AleDedor/STM32Nucleo-Codec-Shield/project_slides.pdf

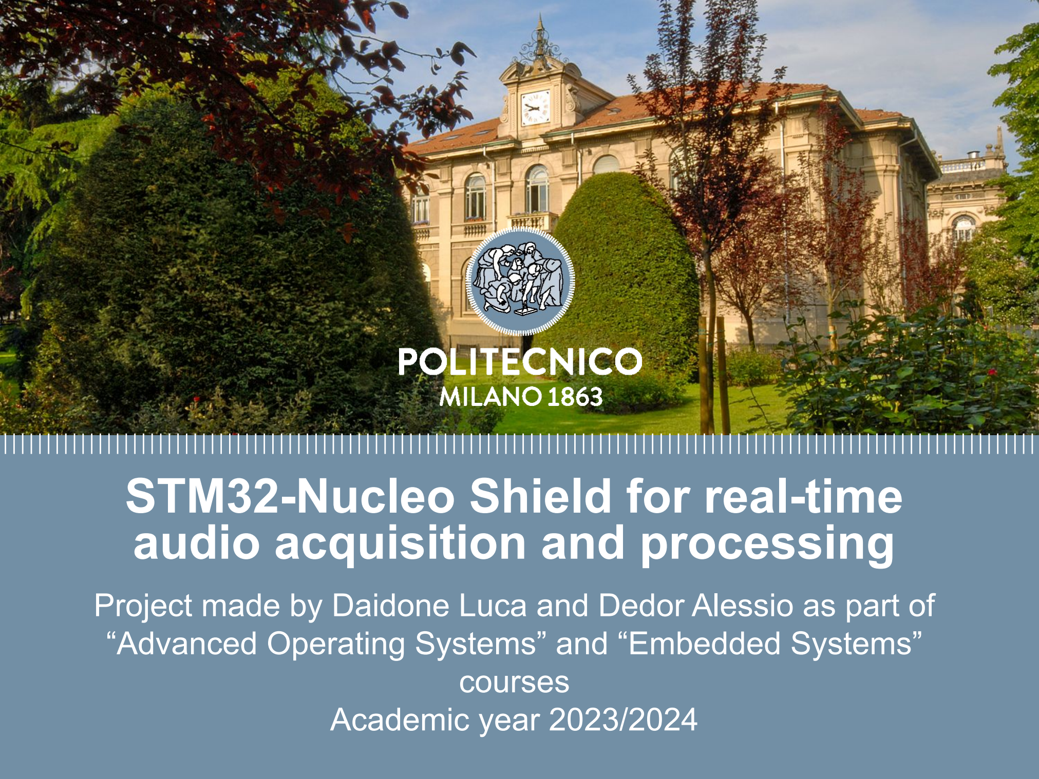
[picture p9: page 1]

### Titolo presentazione sottotitolo

Milano, XX mese 20XX

## STM32-Nucleo Shield for real-time audio acquisition and processing

Project made by Daidone Luca and Dedor Alessio as part of “Advanced Operating Systems” and “Embedded Systems” courses
Academic year 2023/2024

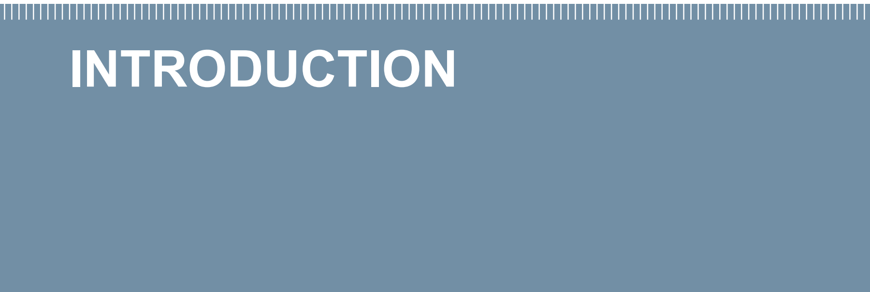
[picture p10: figure]
Firma convenzione; del Duomo di Milano; Aula Magna – Rettorato Mercoledì 27 maggio 2015; INTRODUCTION

### Politecnico di Milano e Veneranda Fabbrica

STM32 Nucleo Audio Shield project

## Project goals

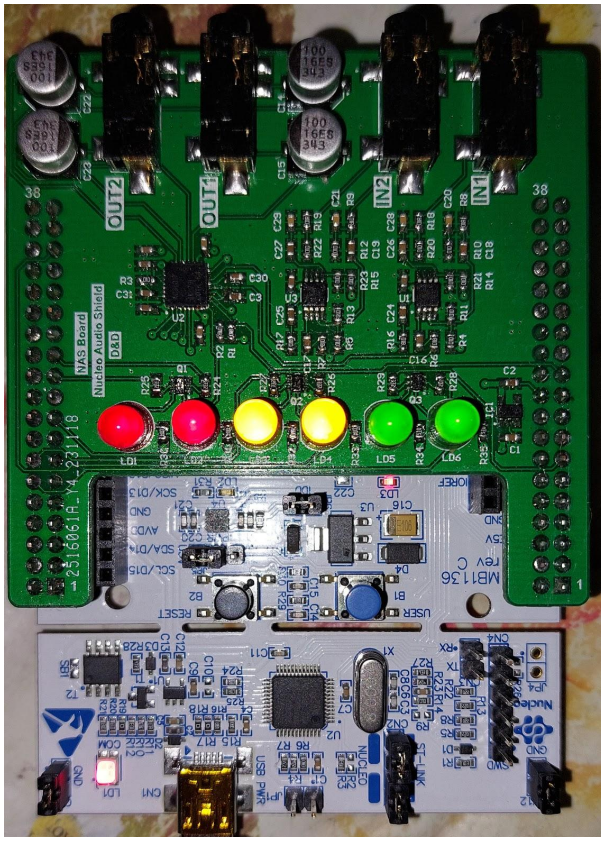
[picture p11: figure]

Design of a | TLV320AIC3101 Codec | based
shield targeting | STM32F401RE Nucleo
boards | and | development | of | a
multi-threaded | program | for | real-time
audio data processing.

Aim of the project is to:
1. Design and realize a custom “shield” to add audio processing capabilities to the STM32 Nucleo boards
2. Use the embedded RTOS “Miosix” to implement an I2S Driver and exploit
the | advantages | of | multi-threaded
programming

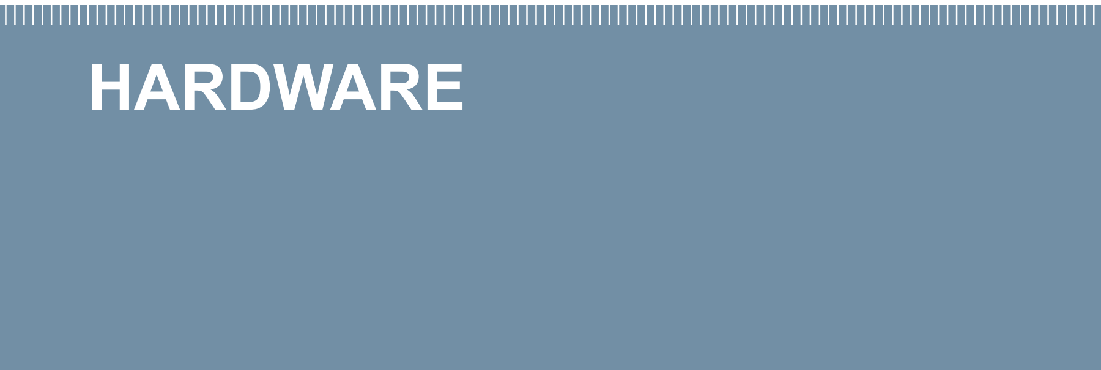
[picture p12: figure]
Firma convenzione; del Duomo di Milano; Aula Magna – Rettorato Mercoledì 27 maggio 2015; HARDWARE

### Politecnico di Milano e Veneranda Fabbrica

Starting from the schematic..

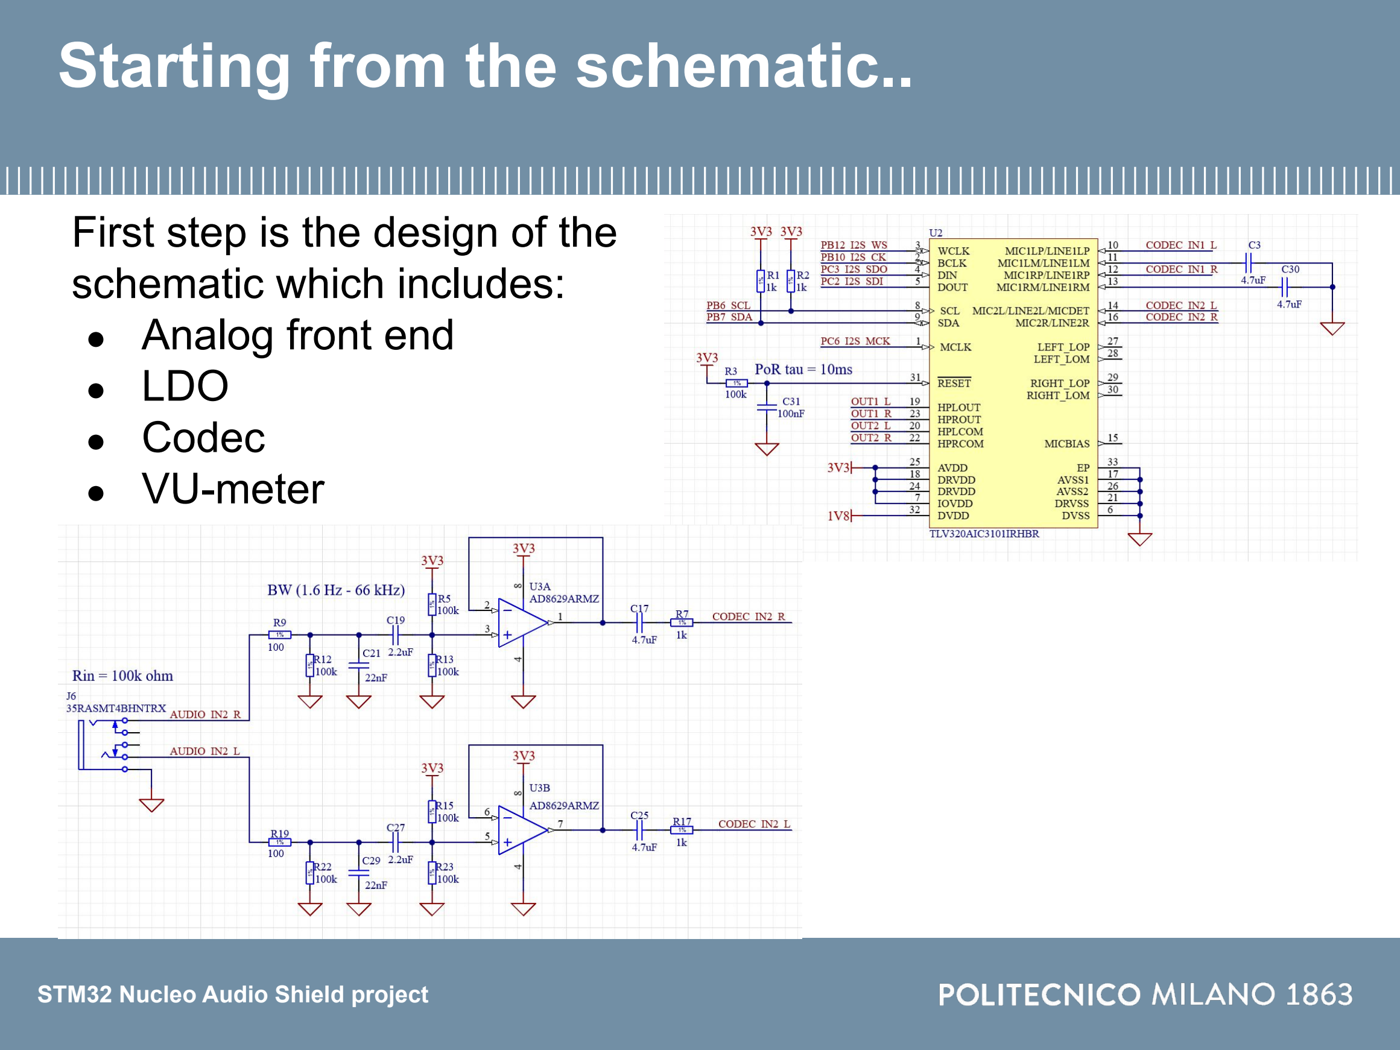
[picture p13: page 5]

First step is the design of the schematic which includes:
- Analog front end
- LDO
- Codec
- VU-meter

## Full schematic

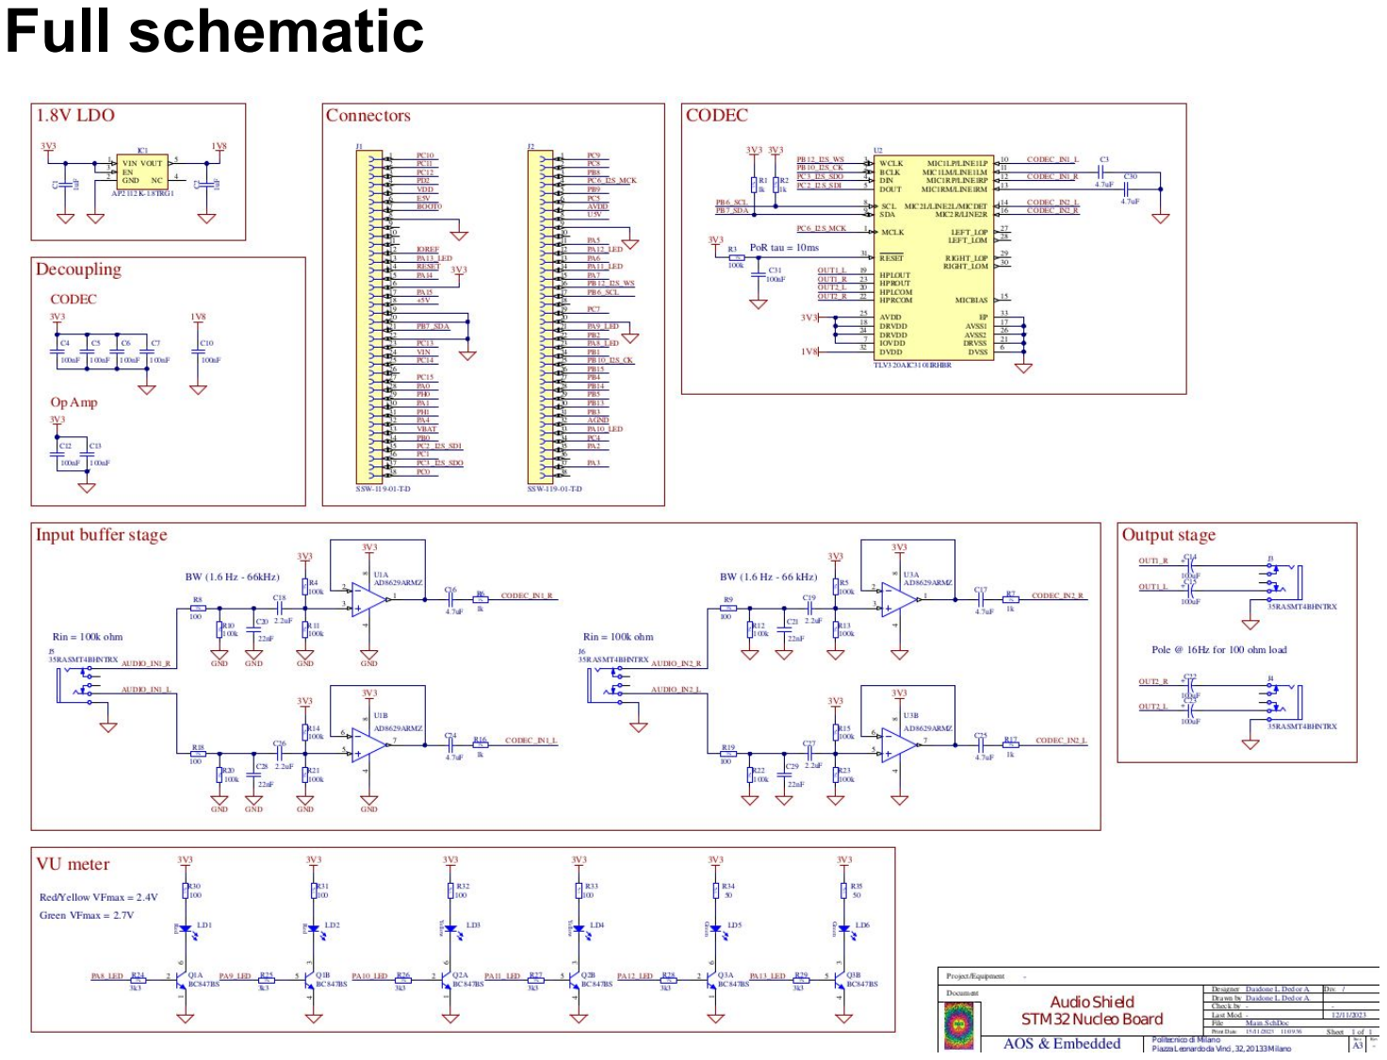
[picture p14: page 6]

# Full Schematic

## ..continuing to the Layout

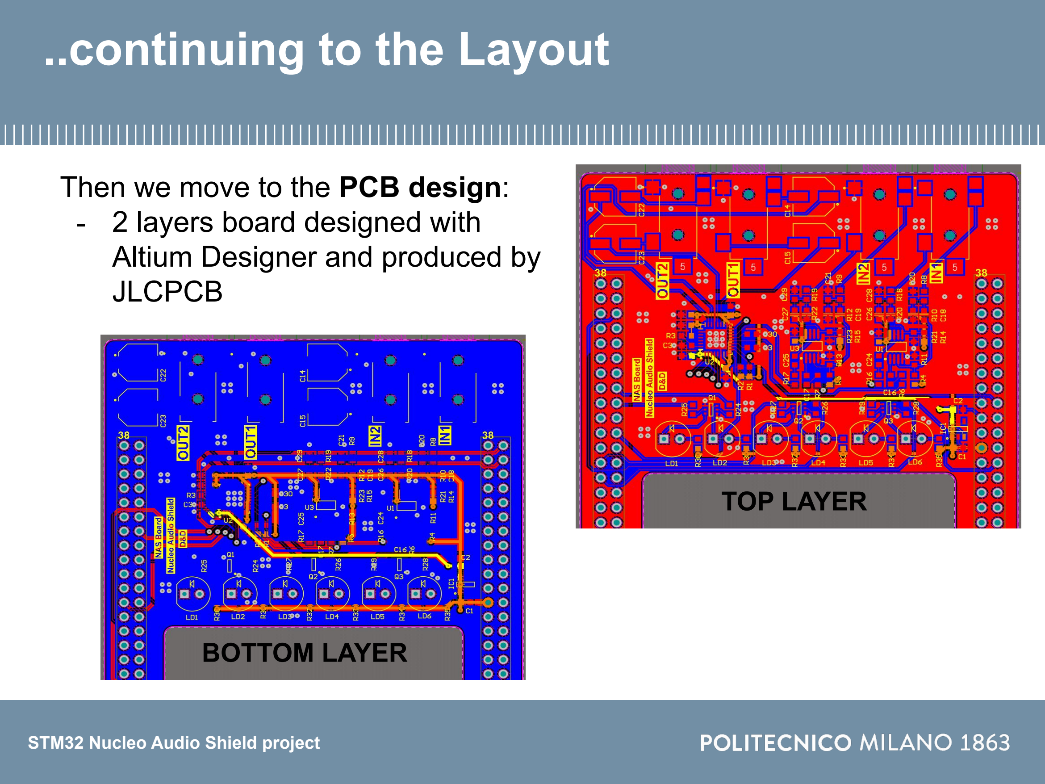
[picture p15: page 7]

Then we move to the PCB design:
- 2 layers board designed with Altium Designer and produced by JLCPCB

BOTTOM LAYER

TOP LAYER

## ..and finishing with soldering + testing

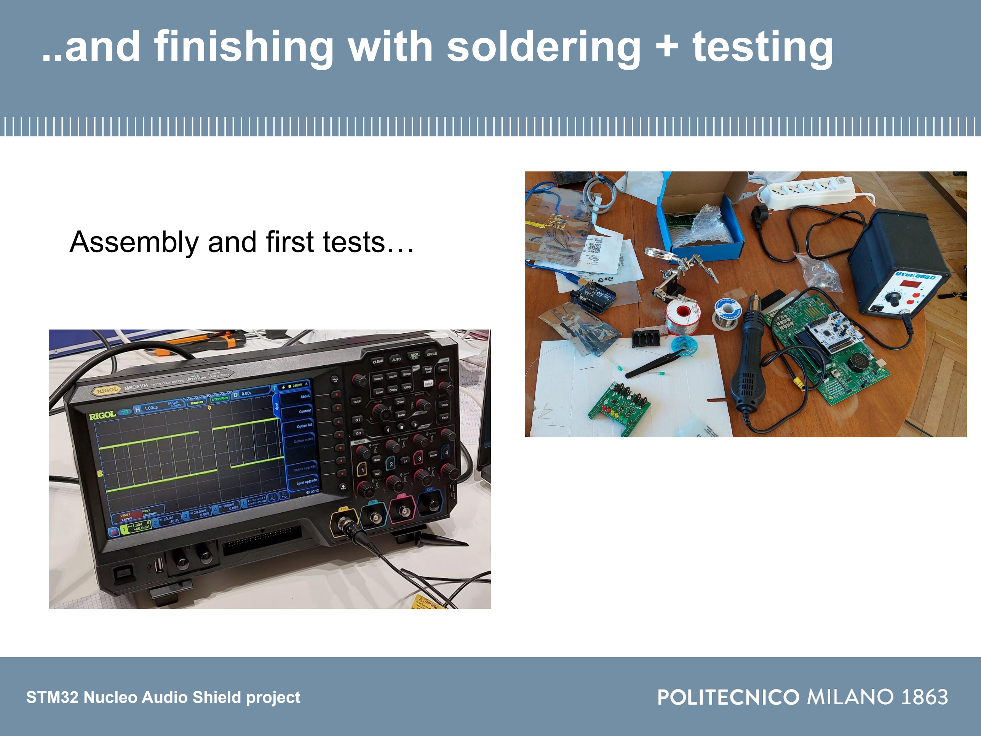
[picture p16: page 8]

Assembly and first tests…

## Final considerations (HW)

Problems encountered:

1. VU-meter was meant to have 6 fully working LEDs but only 5 of them can be currently used. One is directly connected to the SWD port and setting it as an output would not allow us to successfully “flash” the MCU using the “st-flash” tool. This can probably be easily fixed but was not investigated yet
2. Signal Integrity: due to initial misunderstanding about the I2S protocol, a trace carrying audio signals was routed close to traces carrying high frequency digital signals causing some audible distortion under certain conditions
3. The selected Codec comes in a package which is not easy to solder. A too long heat exposition damaged the output audio stage

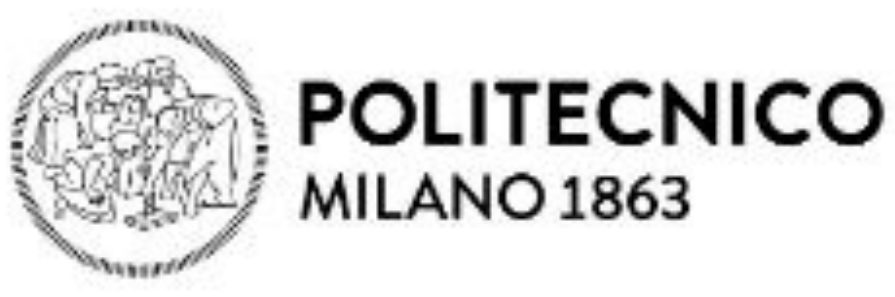
[picture p17: figure]
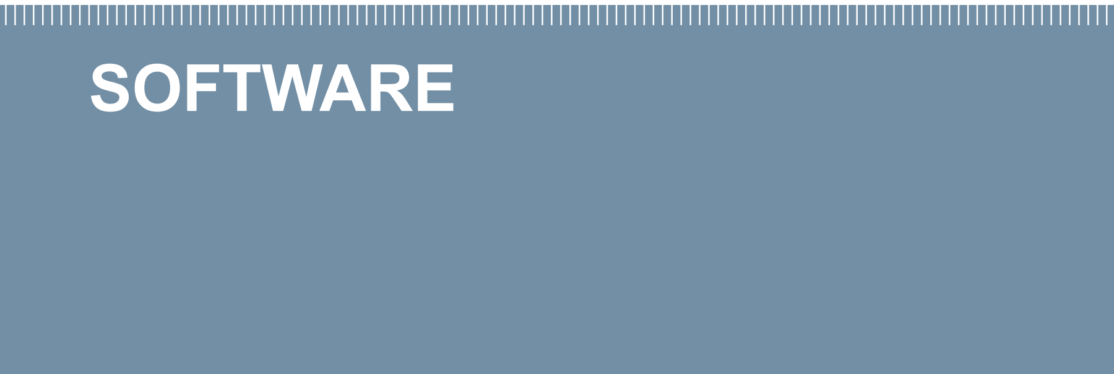
[picture p18: figure]
Firma convenzione; del Duomo di Milano; Aula Magna – Rettorato Mercoledì 27 maggio 2015; SOFTWARE

### Politecnico di Milano e Veneranda Fabbrica

## Goals

Software must provide libraries/functions to easily manage all the HW present on the board, which are:
- Codec
- VU-meter
- I2S peripherals on codec and STM32

Finally, a simple loopback and a VU-meter showcase should be realized.

## VU-Meter

The class “Vumeter” takes the specified GpioPin (5 pins) and provides some basic methods.

- The constructor set the specified pins, passed as parameters, as “outputs”.
- setHigh() and clear() allow to turn on/off all the leds of the VU-meter.
- showVal(uint), finally takes the sound value, converts it in a log scale and turns on the corresponding number of leds.

The class is defined inside the vumeter.h header file.

## VU-Meter

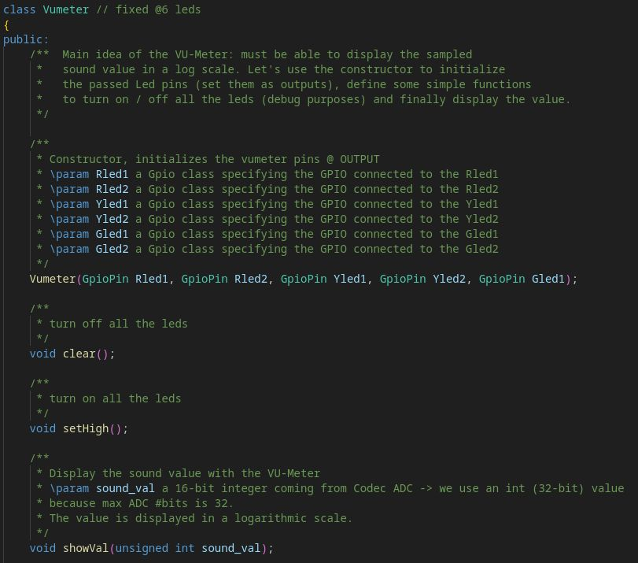
[picture p19: figure]

## Codec driver: TLV320AIC3101 class

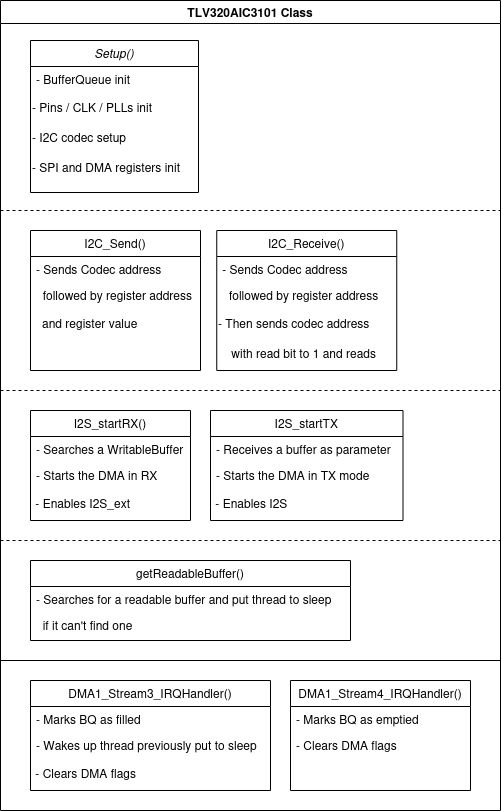
[picture p20: figure]

## Codec

The class “TLV3203101AIC” instantiate the codec object in a Singleton manner such as only one instance can exist.

The codec uses two different communication protocols:
- I2C, it is needed to change the codec settings/functionalities and directly R/W its registers
- I2S, used to receive/transfer audio data

The class is defined inside the TLV3203101AIC.h header file, while all the implementations are moved inside the TLV3203101AIC.cpp file.

## Codec

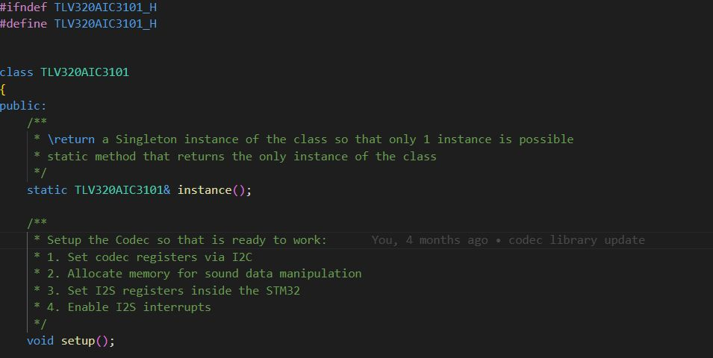
[picture p21: figure]

## Codec - I2C

In order to easily communicate through I2C protocol:
1. We used the “SoftwareI2C” class of Miosix to implement two
methods, “I2C_Send(unsigned | char | regAddress, | char | data)“ and
“
I2C_Receive(unsigned | char | regAddress)

“

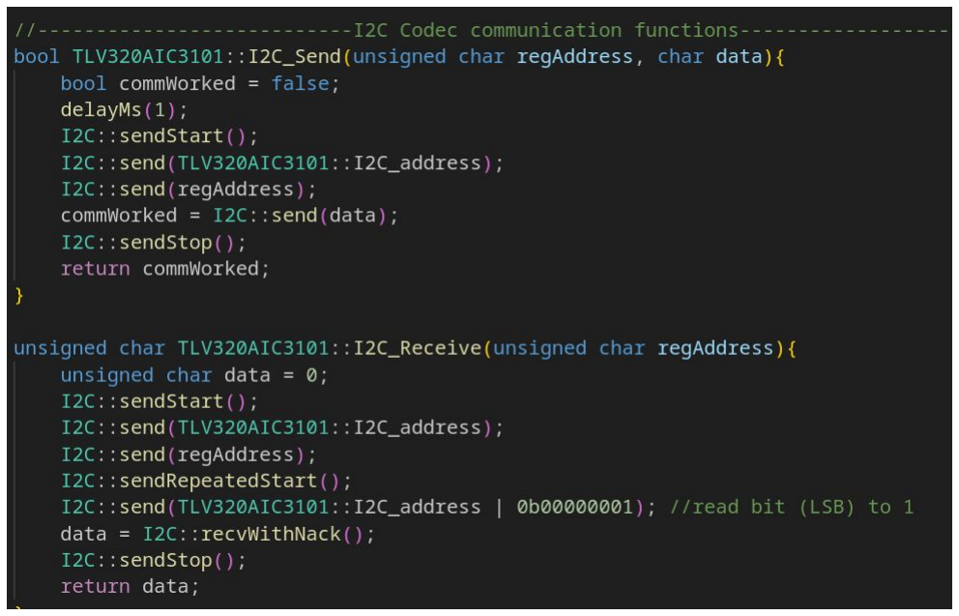
[picture p22: figure]

## Codec - I2C

2. Then we implemented a “setup()” method where the “I2C_Send()” function is used to setup the I2C peripheral and initialize all the needed codec registers.

And so on…

## Codec - I2S

Audio data is sampled by the codec and then transferred to the MCU through I2S protocol. Since our goal is to receive and then send back the manipulated audio data, we need to exploit the I2S in full-duplex mode. Also, in order to avoid keeping the CPU busy, we use the DMA and its interrupt routines.

Therefore an “I2S driver” is needed. For this purpose, the TLV320AIC3101 class has the following methods:

- | void | setup();
- | static | bool | I2S_startRx();
- | static | void | I2S_startTx(const | unsigned | short | *buffer_tx);

## Codec - I2S - setup()

In the “setup()” function the following steps are performed:
- enable peripherals clock (DMA1/SPI2)
- setup I2S pins (with correct AF number)
- configure I2S PLL
- configure I2S2/I2S2_ext working mode (Master/Slave)
- setup relative DMAx streams
- enable interrupts

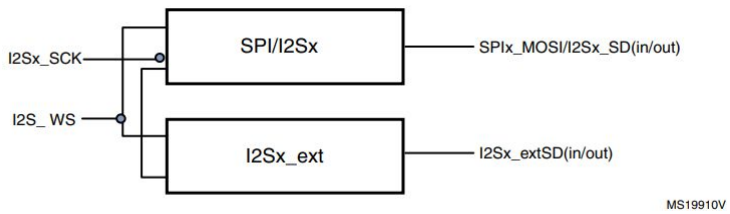
[picture p23: figure]

## Codec - I2S - I2S_startRx()/I2S_startTx()

The role of the “I2S_startRx()” function is to:
- find a writable buffer among the ones of the BufferQueue
- Set DMA1 (Stream 3) to transfer from peripheral (I2S) to memory, then start it
- enable I2S2_ext peripheral

Similarly the role of the “I2S_startTx()” function is to:
- take the buffer filled with audio data as a parameter
- Set DMA1 (Stream 4) to transfer from memory to peripheral, then start it
- enable SPI2 (I2S2) peripheral

Note that both these methods use a “FastInterruptDisableLock dLock;” before setting everything up.

## DMA1 ISR

Since both DMA1 Stream3/Stream4 interrupts have been enabled, we need to manage the relative Interrupt Service Routines. Apart from clearing all the interrupts flags we basically just mark the buffer which was just transmitted as “empty” and the one that was received as “filled”.

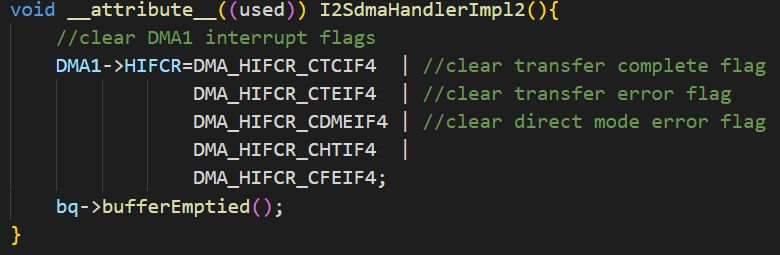
[picture p24: figure]

## DEMO

Finally inside the “main.cpp” file we implemented a simple showcase of the project. The main idea here is:

- to create a thread that manages the VU-meter displaying the audio values when a buffer is readable
- create another thread that uses the methods described before to start I2S in RX mode and TX mode in order to implement a simple loopback - audio is immediately sent back as soon as it is received

In order to avoid that the data buffer is modified while it is being read by the VU-meter thread, a “Lock<Mutex> lock(mutex);” is employed

## Demo flow chart

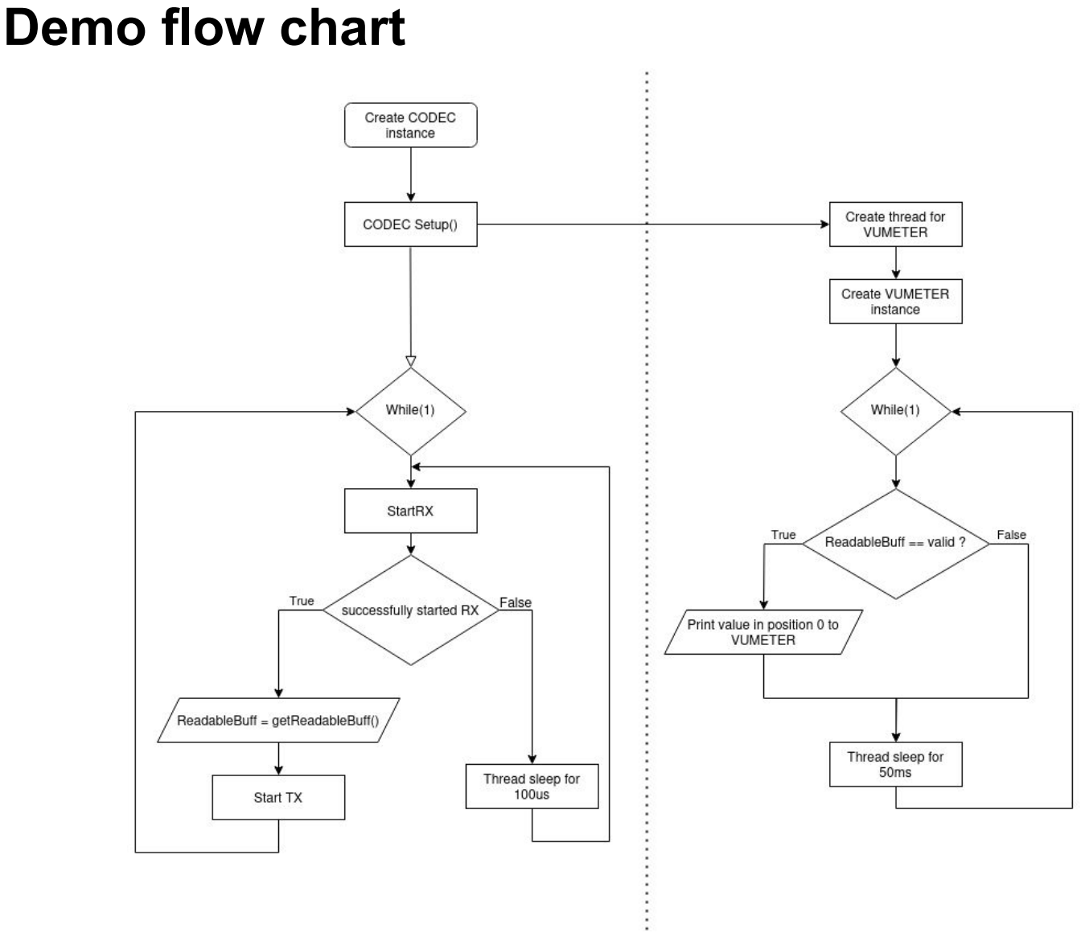
[picture p25: page 24]

## Flowchart
