AleDedor/STM32Nucleo-Codec-Shield/Schematic/Nucleo_Codec_Shield.pdf

3V3 | 1V8

3V3

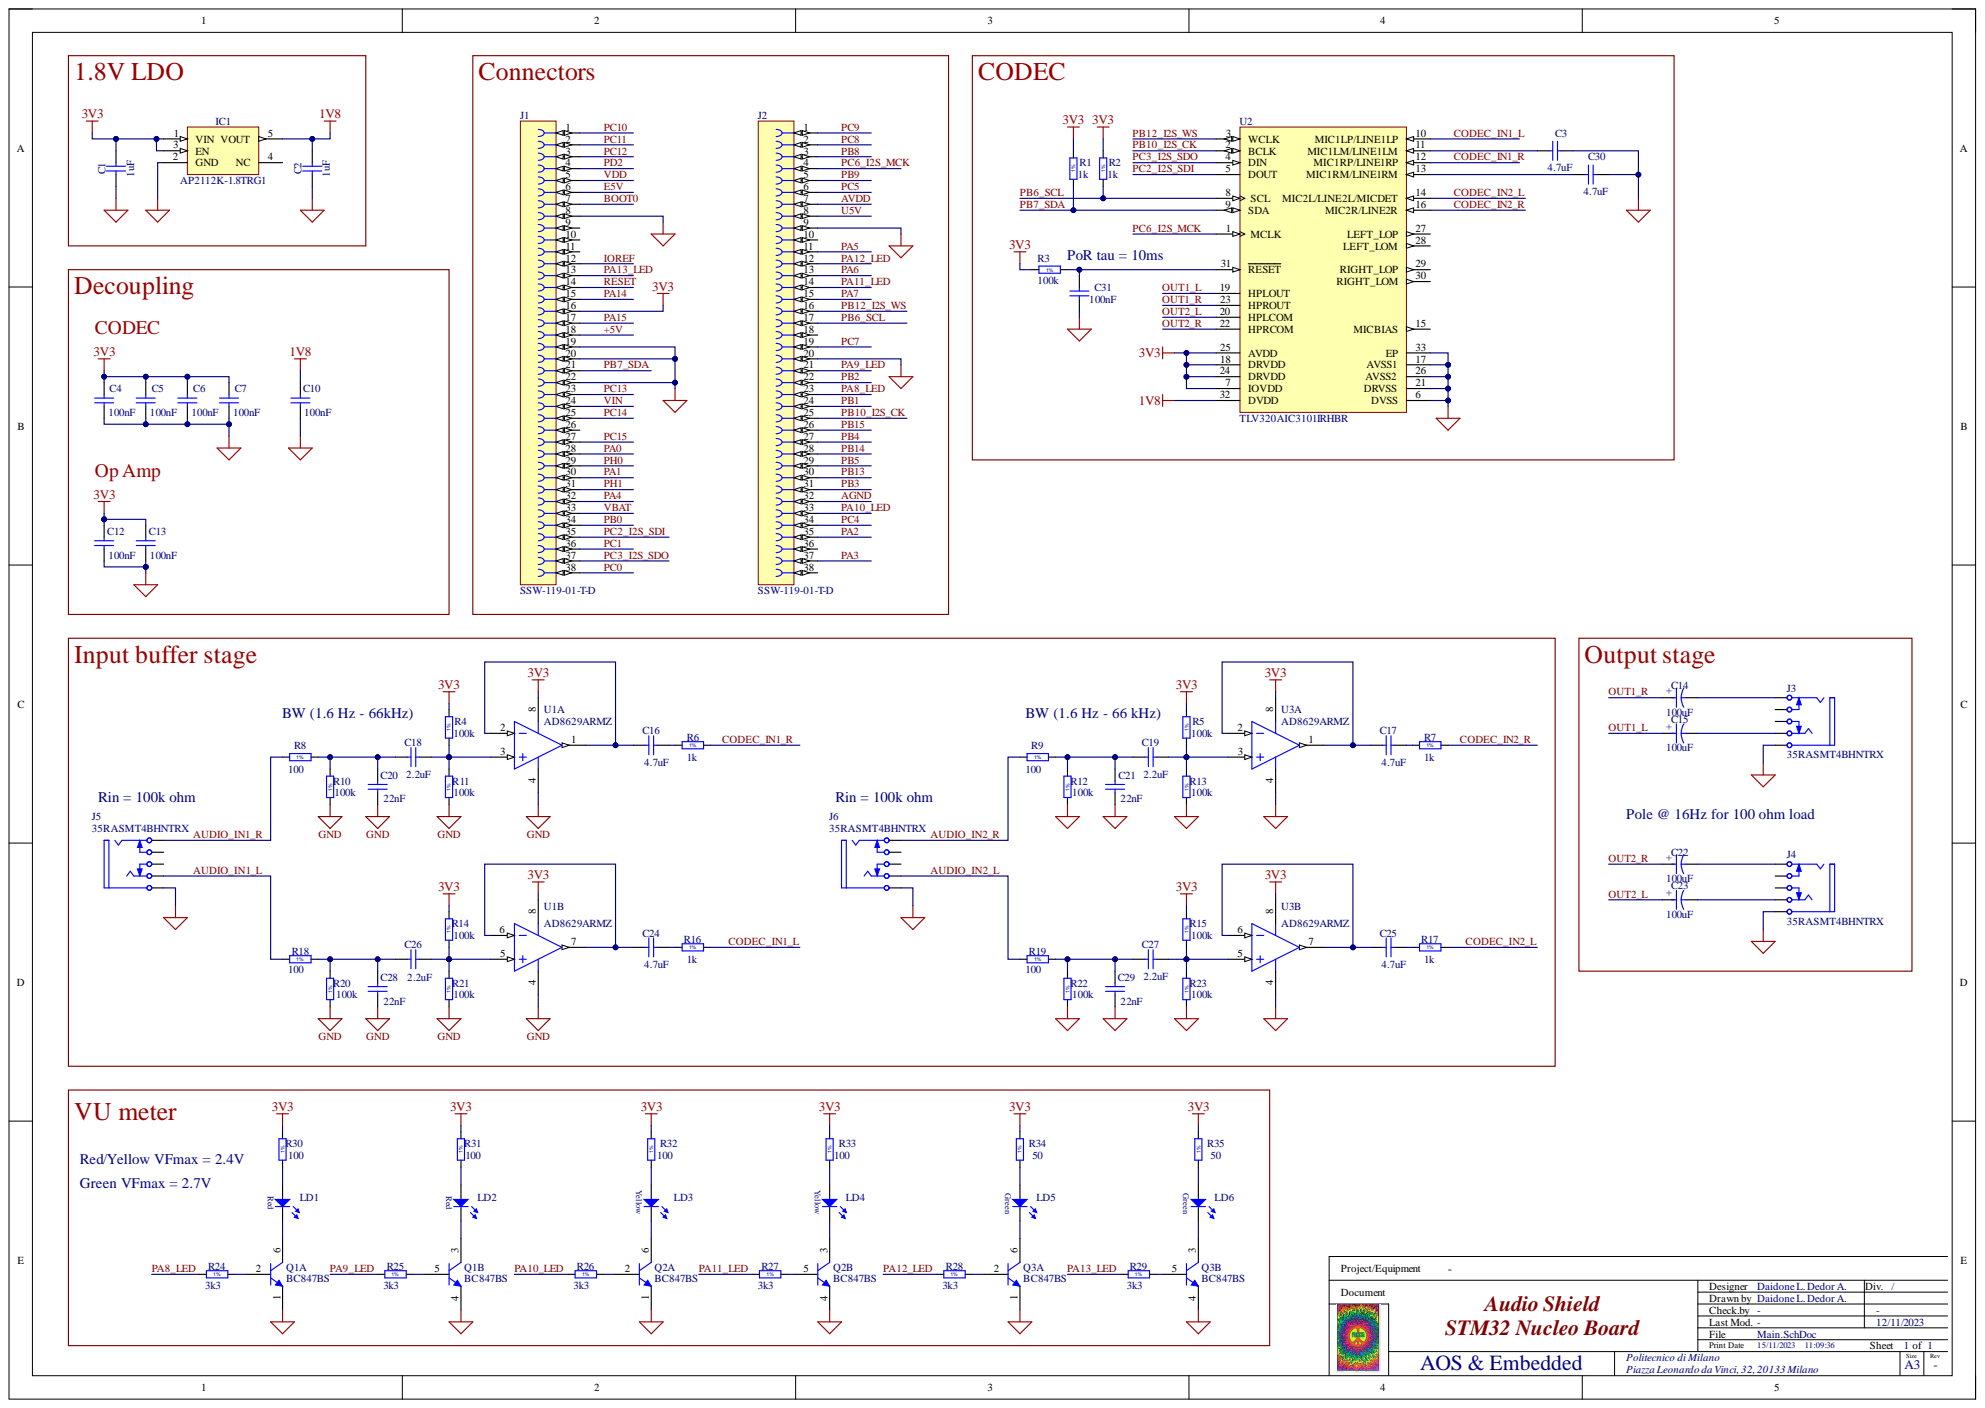
[picture p26: page 1]

Pole @ 16Hz for 100 ohm load

Designer DaidoneL. Dedor A.
Drawn by DaidoneL. Dedor A.

Politecnico di Milano
Piazza Leonardo da Vinci, 32, 20133 Milano

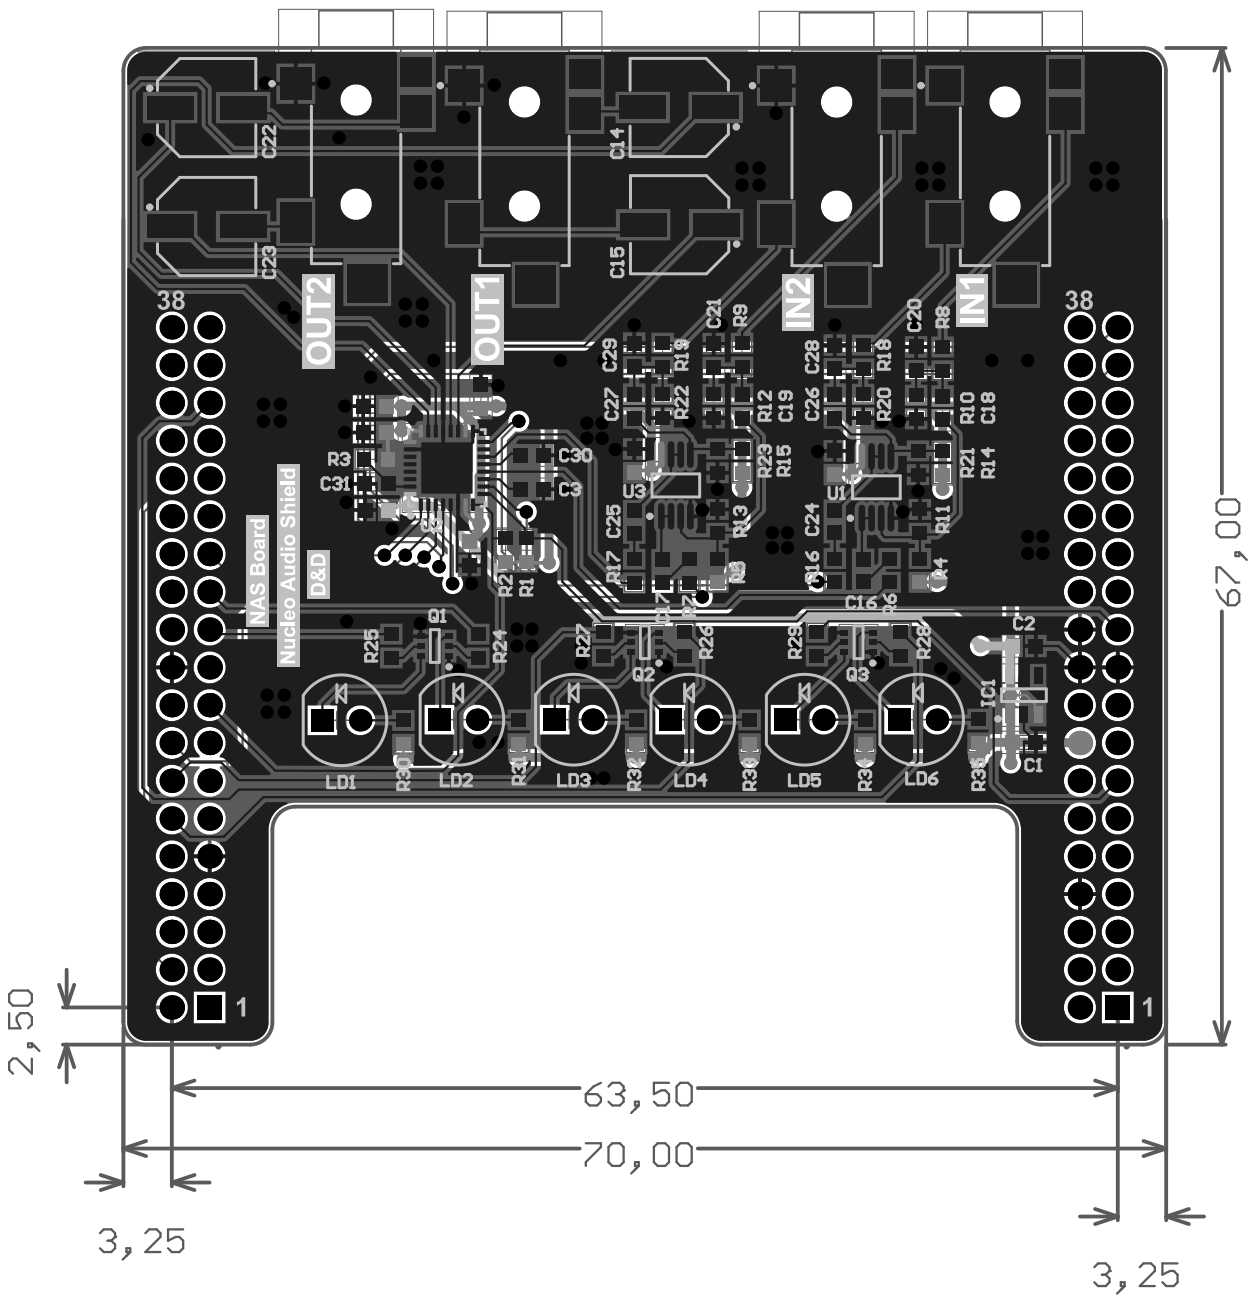
[picture p27: page 2]
