AleDedor/STM32Nucleo-Codec-Shield/Simulation/Analogue_IN.asc

C1: cap; 2µ
C3: cap; 470p
C4: cap; 1µ
C5: cap; 22n
R1: res; 100k
R2: res; 100k
R3: res; 100
R4: res; 100k
R5: res; 100k
R6: res; 100
R7: res; 100k
U1: AD8629
V1: voltage; 3.3
V2: voltage; SINE(0 10m 20k); AC 10m
V3: voltage; 1.65
Named nets: 0, 3V3, 1V65, audio
.ac dec 100 0.1m 10Meg
2 CONDENSATORI = LIMITARE BANDA (HP + LP)
SOLUZIONE DI PHIL'S = RICHIEDE OPAMP PER IL BIAS :(
SOLUZIONE MIA = NO OPA PER BIAS, POLO HF CON LEGGERE Q FACTOR ELEVATO
.tran 0.2m
Q-FACTOR ABBASSATO PONENDO PRIMA IL CONDENSATORE, 100k INPUT PER EVITARE FLOATING
