AleDedor/STM32Nucleo-Codec-Shield/NAS_Loopback_2/Core/Src/main.c

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
/* Includes ------------------------------------------------------------------*/
#include "main.h"

/* USER CODE BEGIN Includes */
#include "stdio.h"
#include "TLV320AIC3101_Codec.h"
/* USER CODE END Includes */

/* USER CODE BEGIN PD */
#define HIGH 1
#define LOW 0
#define NUM_LEDS 5
#define TIMEOUT 500
#define BUFF_SIZE 50
#define RESET_TIME 50 
/* USER CODE END PD */

I2C_HandleTypeDef hi2c1;

I2S_HandleTypeDef hi2s2;
DMA_HandleTypeDef hdma_spi2_tx;
DMA_HandleTypeDef hdma_i2s2_ext_rx;

TIM_HandleTypeDef htim3;

UART_HandleTypeDef huart2;

/* USER CODE BEGIN PV */
uint8_t TIM3_ISR_FLAG = 0;
uint16_t LED_PIN[NUM_LEDS]={RLED1_Pin, RLED2_Pin, YLED1_Pin, YLED2_Pin, GLED1_Pin};
Codec codec;
// buffer of sound data where odd indexes are left channel, even are right one
uint16_t rx_data[BUFF_SIZE];
uint16_t tx_data[BUFF_SIZE];
static volatile uint16_t* inBufPtr;
static volatile uint16_t* outBufPtr = &tx_data[0];
char buff[100];
/* USER CODE END PV */

void SystemClock_Config(void);
static void MX_GPIO_Init(void);
static void MX_DMA_Init(void);
static void MX_USART2_UART_Init(void);
static void MX_I2C1_Init(void);
static void MX_TIM3_Init(void);
static void MX_I2S2_Init(void);
/* USER CODE BEGIN PFP */
static void Led_Clear();
//static void Codec_Setup();
/* USER CODE END PFP */

/* USER CODE BEGIN 0 */
static void Led_Clear(){
	HAL_GPIO_WritePin(GPIOA, RLED1_Pin|RLED2_Pin|YLED1_Pin|YLED2_Pin|GLED1_Pin, GPIO_PIN_RESET);
}

/* 2 DMA streams are used, 1 RX ,1 TX */
/* move half of the receiving DMA into the half of the transmitting DMA */
void process_half(){

	uint16_t volume = 0;

	for(uint8_t n=0 ; n < (BUFF_SIZE/2) - 1; n++){
		//LEFT
		*(outBufPtr+n)=*(inBufPtr+n); //tx_data --> rx_data
		//RIGHT
		//outBufPtr[n+1]=inBufPtr[n+1];

		//VU METER FATTO MALE SOLO PER PROVARE
		volume = (*(inBufPtr+n));
		Led_Clear();
		if(volume>55296){
			HAL_GPIO_WritePin(GPIOA, LED_PIN[0], HIGH);
			HAL_GPIO_WritePin(GPIOA, LED_PIN[1], HIGH);
			HAL_GPIO_WritePin(GPIOA, LED_PIN[2], HIGH);
			HAL_GPIO_WritePin(GPIOA, LED_PIN[3], HIGH);
			HAL_GPIO_WritePin(GPIOA, LED_PIN[4], HIGH);
			//HAL_GPIO_WritePin(GPIOA, LED_PIN[5], HIGH);
		}else if(volume<55296 && volume>13824){
			HAL_GPIO_WritePin(GPIOA, LED_PIN[1], HIGH);
			HAL_GPIO_WritePin(GPIOA, LED_PIN[2], HIGH);
			HAL_GPIO_WritePin(GPIOA, LED_PIN[3], HIGH);
			HAL_GPIO_WritePin(GPIOA, LED_PIN[4], HIGH);
			//HAL_GPIO_WritePin(GPIOA, LED_PIN[5], HIGH);
		}else if(volume<13824 && volume>4608){
			HAL_GPIO_WritePin(GPIOA, LED_PIN[2], HIGH);
			HAL_GPIO_WritePin(GPIOA, LED_PIN[3], HIGH);
			HAL_GPIO_WritePin(GPIOA, LED_PIN[4], HIGH);
			//HAL_GPIO_WritePin(GPIOA, LED_PIN[5], HIGH);
		}else if(volume<4608 && volume>1536){
			HAL_GPIO_WritePin(GPIOA, LED_PIN[3], HIGH);
			HAL_GPIO_WritePin(GPIOA, LED_PIN[4], HIGH);
			//HAL_GPIO_WritePin(GPIOA, LED_PIN[5], HIGH);
		}else if(volume<1536 && volume>512){
			HAL_GPIO_WritePin(GPIOA, LED_PIN[4], HIGH);
			//HAL_GPIO_WritePin(GPIOA, LED_PIN[5], HIGH);
		}else if(volume<512 && volume>0){
			//HAL_GPIO_WritePin(GPIOA, LED_PIN[5], HIGH);
		}
	}
}

/* first half ready DMA callback*/
void HAL_I2SEx_TxRxHalfCpltCallback(I2S_HandleTypeDef *hi2s){
	inBufPtr = rx_data; // pointing to rx_data of DMA
	outBufPtr = tx_data; // pointing to tx_data of DMA
	process_half(); // move data from RX to TX DMA

}
/* second half ready DMA callback*/
void HAL_I2SEx_TxRxCpltCallback(I2S_HandleTypeDef *hi2s){
	inBufPtr = (rx_data + BUFF_SIZE/2);
	outBufPtr = (tx_data + BUFF_SIZE/2);
	process_half(); // move data from RX to TX DMA
}
/*
void HAL_I2S_RxHalfCpltCallback(I2S_HandleTypeDef *hi2s){
	//HAL_I2S_Transmit_(hi2s, rx_data, BUFF_SIZE/2, 10);
	HAL_I2S_Transmit_DMA(&hi2s2, rx_data, BUFF_SIZE/2);
}
void HAL_I2S_RxCpltCallback(I2S_HandleTypeDef *hi2s){
	//HAL_I2S_Transmit(hi2s, (rx_data + BUFF_SIZE/2), BUFF_SIZE/2, 10);
	HAL_I2S_Transmit_DMA(&hi2s2, (rx_data + BUFF_SIZE/2), BUFF_SIZE/2);
}
*/
/*TIMER 3 used to turn on LED every second*/
void HAL_TIM_PeriodElapsedCallback(TIM_HandleTypeDef *htim){
	if(htim == &htim3)
		TIM3_ISR_FLAG = 1;
}


/* USER CODE END 0 */

/**
  * @brief  The application entry point.
  * @retval int
  */
int main(void)
{
  /* USER CODE BEGIN 1 */
  uint8_t led_index = 0, len = 0, reg_val = 0;
  /* USER CODE END 1 */

  /* MCU Configuration--------------------------------------------------------*/

  /* Reset of all peripherals, Initializes the Flash interface and the Systick. */
  HAL_Init();

  /* Configure the system clock */
  SystemClock_Config();

  /* Initialize all configured peripherals */
  MX_GPIO_Init();
  MX_DMA_Init();
  MX_USART2_UART_Init();
  MX_I2C1_Init();
  MX_TIM3_Init();
  MX_I2S2_Init();
  /* USER CODE BEGIN 2 */

  /* Wait for Codec HW reset */
  HAL_Delay(RESET_TIME);


  /* Codec Setup */
  if(Codec_Init(&codec, &hi2c1) != HAL_OK){
	  while(1){
	  		  HAL_GPIO_TogglePin(GPIOA, LD2_Pin);
	  		  HAL_Delay(300);
	  }}
  else{
	  len = snprintf(buff, sizeof(buff),"Inizializzazione Codec riuscita.\r\n");
	  HAL_UART_Transmit(&huart2, (uint8_t*)buff, len, 100);
  }

  /* Check registers value to be ok */
  Codec_ReadRegister(&codec, 0x0B, &reg_val);
  len = snprintf(buff, sizeof(buff),"Registro 11: %x \r\n", reg_val);
  HAL_UART_Transmit(&huart2, (uint8_t*)buff, len, 100);
  HAL_Delay(10);

  Codec_ReadRegister(&codec, 0x24, &reg_val);
  len = snprintf(buff, sizeof(buff),"Registro 36: %x \r\n", reg_val);
  HAL_UART_Transmit(&huart2, (uint8_t*)buff, len, 100);
  HAL_Delay(10);

  Codec_ReadRegister(&codec, 0x5E, &reg_val);
  len = snprintf(buff, sizeof(buff),"Registro 94: %x \r\n", reg_val);
  HAL_UART_Transmit(&huart2, (uint8_t*)buff, len, 100);
  HAL_Delay(10);

  Codec_ReadRegister(&codec, 0x5F, &reg_val);
  len = snprintf(buff, sizeof(buff),"Registro 95: %x \r\n", reg_val);
  HAL_UART_Transmit(&huart2, (uint8_t*)buff, len, 100);
  HAL_Delay(10);

  Codec_ReadRegister(&codec, 0x60, &reg_val);
  len = snprintf(buff, sizeof(buff),"Registro 96: %x \r\n", reg_val);
  HAL_UART_Transmit(&huart2, (uint8_t*)buff, len, 100);

  HAL_Delay(TIMEOUT);

  /* Start I2S with DMA */
  if(HAL_I2SEx_TransmitReceive_DMA(&hi2s2, tx_data, rx_data, BUFF_SIZE) != HAL_OK){
	  while(1){
		  HAL_GPIO_TogglePin(GPIOA, LD2_Pin);
		  HAL_Delay(300);
	  }}
  else{
	  len = snprintf(buff, sizeof(buff),"Startato DMA per I2S\n\n");
	  HAL_UART_Transmit(&huart2, (uint8_t*)buff, len, 100);
  }


  //Start the Timer 3 to turn on LEDS
  HAL_TIM_Base_Start_IT(&htim3);

  /* USER CODE END 2 */

  /* Infinite loop */
  /* USER CODE BEGIN WHILE */

  while (1){
	  /*if(TIM3_ISR_FLAG){
		  //set new led
		  HAL_GPIO_WritePin(GPIOA, LED_PIN[led_index], HIGH);
		  led_index++;
		  if(led_index == NUM_LEDS+1){
			  led_index = 0;
			  //reset leds
			  Led_Clear();
		  }
		  TIM3_ISR_FLAG = 0;
      // OK, HPLOUT+HPROUT on, not short circuited
      // OK, HPLCOM+HPRCOM on, not short circuited
      // OK, DAC selected L2 path to high power outs + OK, not muted 

	  }*/

	  //HAL_I2S_Receive_DMA(&hi2s2, rx_data, BUFF_SIZE);

    /* USER CODE END WHILE */

    /* USER CODE BEGIN 3 */
  }
  /* USER CODE END 3 */
}

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
