AleDedor/STM32Nucleo-Codec-Shield/NAS_Loopback_2/Core/Inc/main.h

#define B1_Pin GPIO_PIN_13
#define B1_GPIO_Port GPIOC
#define USART_TX_Pin GPIO_PIN_2
#define USART_TX_GPIO_Port GPIOA
#define USART_RX_Pin GPIO_PIN_3
#define USART_RX_GPIO_Port GPIOA
#define LD2_Pin GPIO_PIN_5
#define LD2_GPIO_Port GPIOA
#define RLED1_Pin GPIO_PIN_8
#define RLED1_GPIO_Port GPIOA
#define RLED2_Pin GPIO_PIN_9
#define RLED2_GPIO_Port GPIOA
#define YLED1_Pin GPIO_PIN_10
#define YLED1_GPIO_Port GPIOA
#define YLED2_Pin GPIO_PIN_11
#define YLED2_GPIO_Port GPIOA
#define GLED1_Pin GPIO_PIN_12
#define GLED1_GPIO_Port GPIOA
#define TCK_Pin GPIO_PIN_14
#define TCK_GPIO_Port GPIOA
#define SWO_Pin GPIO_PIN_3
#define SWO_GPIO_Port GPIOB
