AleDedor/STM32Nucleo-Codec-Shield/(commit log)

2023-11-30 It's alive! I2C responding
2023-12-03 added some registers to I2C write function
2023-12-03 added reading of registers and uart
2023-12-13 Reverted old changes, modified periph project
    [TLV320AIC3101_Codec.c, TLV320AIC3101_Codec.h, main.c]
2023-12-19 Delete NAS_periph_test directory
    deleted directory since was bugged (led not working)
    [TLV320AIC3101_Codec.c, TLV320AIC3101_Codec.h, main.c, main.h]
2024-02-22 First test with LEDs, modified main
2024-02-23 Added vumeter.h and flashing led in main
2024-02-25 added filter.h
2024-02-27 Modified I2C send function, now working
2024-02-27 Added first nonsense code to main for testing i2s and DMA (not working, board resets)
    [TLV320AIC3101.h]
2024-02-29 Changed few registers that were wrongly set
    [TLV320AIC3101.cpp]
2024-03-01 Modified registers settings, fixed errors, DMA still not triggering interrupt
    [TLV320AIC3101.cpp, TLV320AIC3101.h]
2024-03-03 Codec register 0x03 was never set, added it, but still not working
    [NAS_Loopback_2.ioc, TLV320AIC3101.cpp]
2024-04-10 both ISR are being triggered, printf is interfering somehow with code
    [TLV320AIC3101.cpp]
2024-04-10 fixed the print that went over the max buffer size
    [TLV320AIC3101.cpp]
2024-04-17 SPI2 - I2S2_ext correct config
    [TLV320AIC3101.cpp, TLV320AIC3101.h]
2024-04-19 Modified order of operations for DMA and I2S
2024-04-19 Minor modification, must fix vumeter
    [TLV320AIC3101.cpp]
2024-07-08 now it's working everytime the code is flashed. Not when reset is performed...
    [TLV320AIC3101.cpp]
