AleDedor/STM32Nucleo-Codec-Shield/(notices)

Notices in the files:
NAS_Loopback_2/Core/Inc/main.h:
Copyright (c) 2023 STMicroelectronics.
All rights reserved.
This software is licensed under terms that can be found in the LICENSE file
